Entropyqwe/Intelligent-pan-tilt-facial-registrationn-system/batch_02/assets/wiring/PA0_PA1_PA2_板端接线放大.png

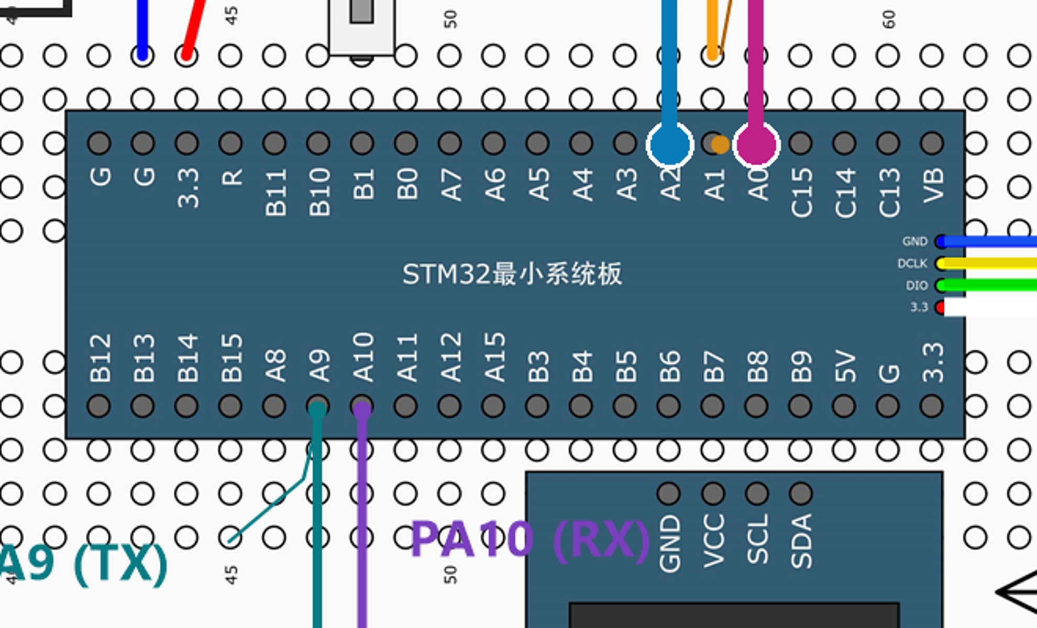
batch_02/assets/wiring/PA0_PA1_PA2_板端接线放大.png
