Entropyqwe/Intelligent-pan-tilt-facial-registrationn-system/batch_02/assets/wiring/原图增补_两轴云台_单电机_20261104.png

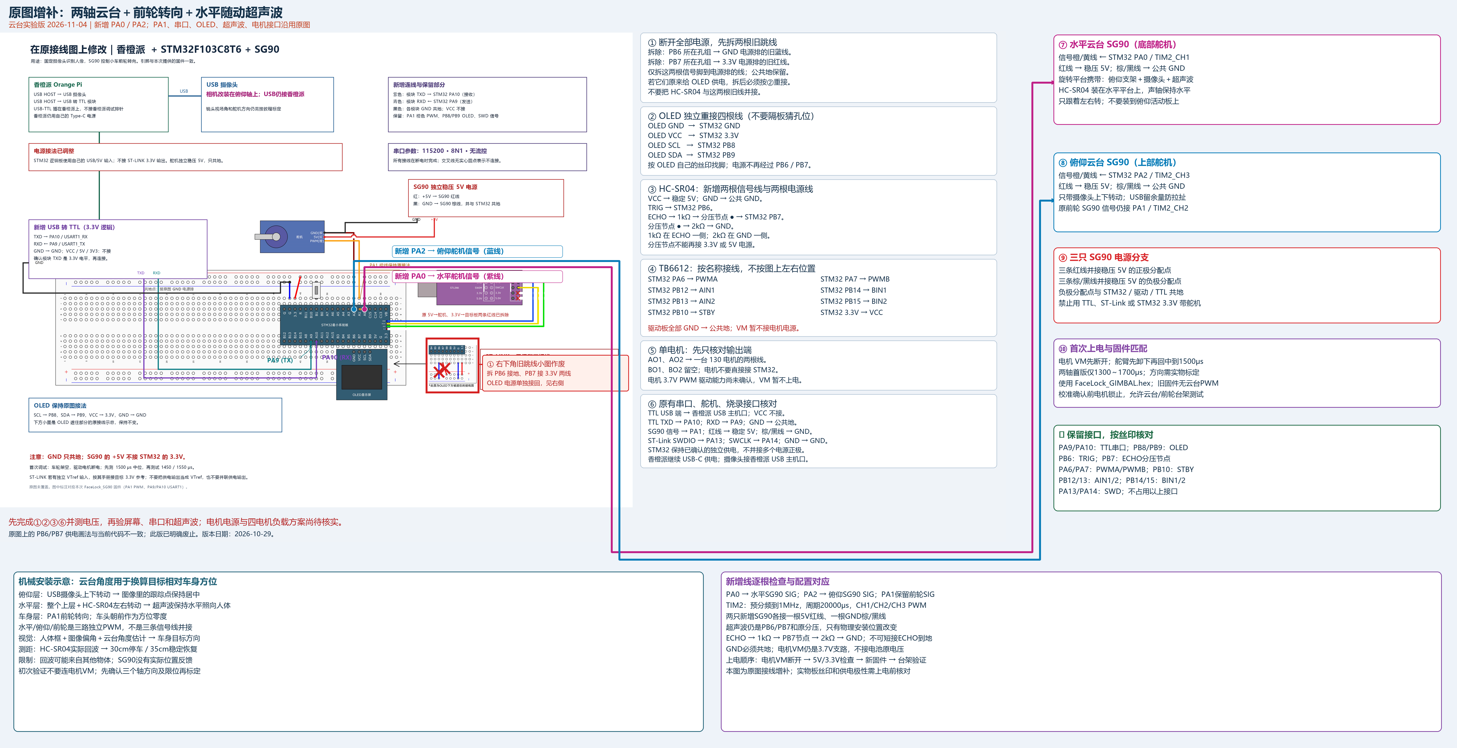
batch_02/assets/wiring/原图增补_两轴云台_单电机_20261104.png
