Entropyqwe/Intelligent-pan-tilt-facial-registrationn-system/batch_03/firmware/tests/native_result_20261029.txt

PASS: exact 3000ms visual-loss hold; repeated invalid does not extend; immediate motor invalid; 500ms link timeout; recovery; tick wrap.
