Entropyqwe/Intelligent-pan-tilt-facial-registrationn-system/batch_02/docs/TEST_RESULTS.md

# 本次软件验证记录

## 结果

| 检查 | 实际结果 |
|---|---|
| Python回归 | **190项通过，0失败，0错误**；含原168项及22项新增用例 |
| 真实YuNet/SFace模型加载 | OpenCV 4.10.0成功；YuNet合成空帧0脸；SFace实际输出`(1,128)`，姓名库存取/匹配通过 |
| 原3个ONNX哈希 | 全部匹配固定SHA256；由已有离线原文件恢复，不是重新下载 |
| C原生测试 | **4组通过**：云台与配对、速度缓升/恢复、丢失3秒保持/断链、OLED状态与距离边界 |
| C编译选项 | GCC C99，`-Wall -Wextra -Werror`；临时目录编译执行，不写正式HEX |
| Shell语法 | 6份`.sh`均经`bash -n`检查通过 |
| Python语法 | `app/`与`tools/`经compileall检查 |
| Keil相对源文件路径 | 67条引用均存在 |
| 原工程保护 | 与复制前基线对比，**458个原文件均未改变** |
| STM32副本 | 复制的固件目录文件全部与源逐字节相同 |
| 正式HEX | SHA256保持`6caf86c0711a6bbe533088cfacfa31bbe1e9537db4fcbe8a68f344b723c649a8` |
| 中文UI | 用明确标注的合成人物画面渲染并人工查看，姓名/语音状态未遮挡帧率、距离与云台状态 |

## 新增用例覆盖

姓名库显式登记/删除、姓名/特征校验、分数与差距拒绝歧义、实际128维模型接口、至少三次连续确认、缺失槽位和突跳撤销、过期/乱序/旧令牌拒绝、未知/缺失脸清除、身份超时、重叠人体/多脸冲突、同一身份多人体跨结果抑制、离场/冷却去重、持续在场不重复欢迎、语音繁忙重试、固定argv及stdin无shell调用、音频失败隔离、有界人脸请求、识别异常隔离、预览无串口、标签模式保留人体source2、严格身份模式未确认时撤销有效控制。

## 未执行或不能由这些测试证明

- 没有连接香橙派进行本次部署、NPU推理实测、CPU占用/温度或20FPS验收。
- 没有实际人脸样本准确率评测，没有登记用户姓名和照片；合成模型测试不能替代真人测试。
- 没有在板端听到espeak-ng播报，异步语音测试使用替代执行器验证调度/参数/故障隔离。
- 没有打开真实摄像头、串口、舵机、电机或超声波，没有烧录STM32。
- 没有完成几何标定或放开电机；保持`calibration_confirmed=false`。
- 未重新获取上游网页与模型；下载工具URL网络可用性受当时网络影响，提供已校验的离线模型恢复路径。

打包前已发现源目录原有校验清单的一份历史交接文档哈希与当前内容不同；本次以实际复制前基线检查原文件，未覆盖或“修正”用户文档。新副本使用自己的SHA256清单。
