Entropyqwe/Intelligent-pan-tilt-facial-registrationn-system/batch_02/firmware/FaceLock_GIMBAL_PinView.ioc

Mcu.UserName=STM32F103C8Tx
PA0-WKUP.GPIO_Label=GIMBAL_PAN
PA0-WKUP.Signal=S_TIM2_CH1_ETR
PA1.GPIO_Label=FRONT_STEER
PA1.Signal=S_TIM2_CH2
PA10.Signal=USART1_RX
PA13.Signal=SYS_JTMS-SWDIO
PA14.Signal=SYS_JTCK-SWCLK
PA2.GPIO_Label=GIMBAL_TILT
PA2.Signal=S_TIM2_CH3
PA6.GPIO_Label=MOTOR_PWMA
PA6.Signal=S_TIM3_CH1
PA7.GPIO_Label=MOTOR_PWMB
PA7.Signal=S_TIM3_CH2
PA9.Signal=USART1_TX
PB10.GPIO_Label=MOTOR_STBY
PB10.Signal=GPIO_Output
PB12.GPIO_Label=AIN1
PB12.Signal=GPIO_Output
PB13.GPIO_Label=AIN2
PB13.Signal=GPIO_Output
PB14.GPIO_Label=BIN1
PB14.Signal=GPIO_Output
PB15.GPIO_Label=BIN2
PB15.Signal=GPIO_Output
PB6.GPIO_Label=US_TRIG
PB6.Signal=GPIO_Output
PB7.GPIO_Label=US_ECHO_DIV
PB7.Signal=S_TIM4_CH2
PB8.GPIO_Label=OLED_SCL_SOFT
PB8.Signal=GPIO_Output
PB9.GPIO_Label=OLED_SDA_SOFT
PB9.Signal=GPIO_Output
PD0-OSC_IN.Signal=RCC_OSC_IN
PD1-OSC_OUT.Signal=RCC_OSC_OUT
