Entropyqwe/Intelligent-pan-tilt-facial-registrationn-system/batch_02/firmware/Hardware/OLED_CN16.h

#ifndef OLED_CN16_H
#define OLED_CN16_H
/* 16x16, vertical LSB first; page 0 then page 1. SimSun screen glyphs. */
static const unsigned char OLED_CN16[][32] = {
    {0x10,0x10,0x10,0xFF,0x10,0x50,0x44,0x54,0x65,0xC6,0x44,0x64,0x54,0x44,0x40,0x00,0x04,0x44,0x82,0x7F,0x01,0x82,0x82,0x4A,0x56,0x23,0x22,0x52,0x4E,0x82,0x02,0x00}, /* U+63A5 */
    {0x00,0xFC,0x00,0x00,0xFF,0x00,0x40,0x20,0xD8,0x17,0x10,0x10,0xF0,0x10,0x10,0x00,0x00,0x0F,0x04,0x02,0xFF,0x00,0x80,0x40,0x21,0x16,0x08,0x16,0x21,0x40,0x80,0x00}, /* U+6536 */
    {0x80,0x60,0xF8,0x07,0x00,0xFC,0x24,0x24,0x25,0x26,0x24,0x24,0x24,0x3C,0x00,0x00,0x00,0x00,0xFF,0x40,0x3C,0x03,0xFF,0x09,0x7F,0x09,0x7F,0x09,0x89,0xFF,0x00,0x00}, /* U+504F */
    {0x20,0x10,0xE8,0x24,0x27,0x24,0x24,0xE4,0x24,0x34,0x2C,0x20,0xE0,0x00,0x00,0x00,0x80,0x60,0x1F,0x09,0x09,0x09,0x09,0x7F,0x09,0x09,0x49,0x89,0x7F,0x00,0x00,0x00}, /* U+89D2 */
    {0x00,0x00,0xFC,0x24,0x24,0x24,0xFC,0x25,0x26,0x24,0xFC,0x24,0x24,0x24,0x04,0x00,0x40,0x30,0x8F,0x80,0x84,0x4C,0x55,0x25,0x25,0x25,0x55,0x4C,0x80,0x80,0x80,0x00}, /* U+5EA6 */
    {0x00,0x3E,0x22,0xE2,0x22,0x3E,0x00,0xFE,0x22,0x22,0x22,0x22,0x22,0xE2,0x02,0x00,0x20,0x3F,0x20,0x1F,0x11,0x11,0x00,0x7F,0x44,0x44,0x44,0x44,0x44,0x47,0x40,0x00}, /* U+8DDD */
    {0x04,0x04,0x04,0xF4,0x84,0xD4,0xA5,0xA6,0xA4,0xD4,0x84,0xF4,0x04,0x04,0x04,0x00,0x00,0xFE,0x02,0x02,0x12,0x3A,0x16,0x13,0x12,0x1A,0x32,0x42,0x82,0x7E,0x00,0x00}, /* U+79BB */
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
    {0x10,0x10,0xD0,0xFF,0x90,0x10,0x00,0xFE,0x02,0x02,0x02,0xFE,0x00,0x00,0x00,0x00,0x04,0x03,0x00,0xFF,0x00,0x83,0x60,0x1F,0x00,0x00,0x00,0x3F,0x40,0x40,0x78,0x00}, /* U+673A */
};
#endif
